atx/TWILight/README.md

TWILight
========

VGA-I2C Breakout board with few LEDs and Atmega. The footprint libraries used are the ones by [oshec](http://library.oshec.org/) and [Dangerous 
Prototypes](http://dangerousprototypes.com/2012/09/18/eagle-parts-our-eagle-library-converted-to-kicad/).
