atx/TWILight/pcb/i2c-vga.pdf

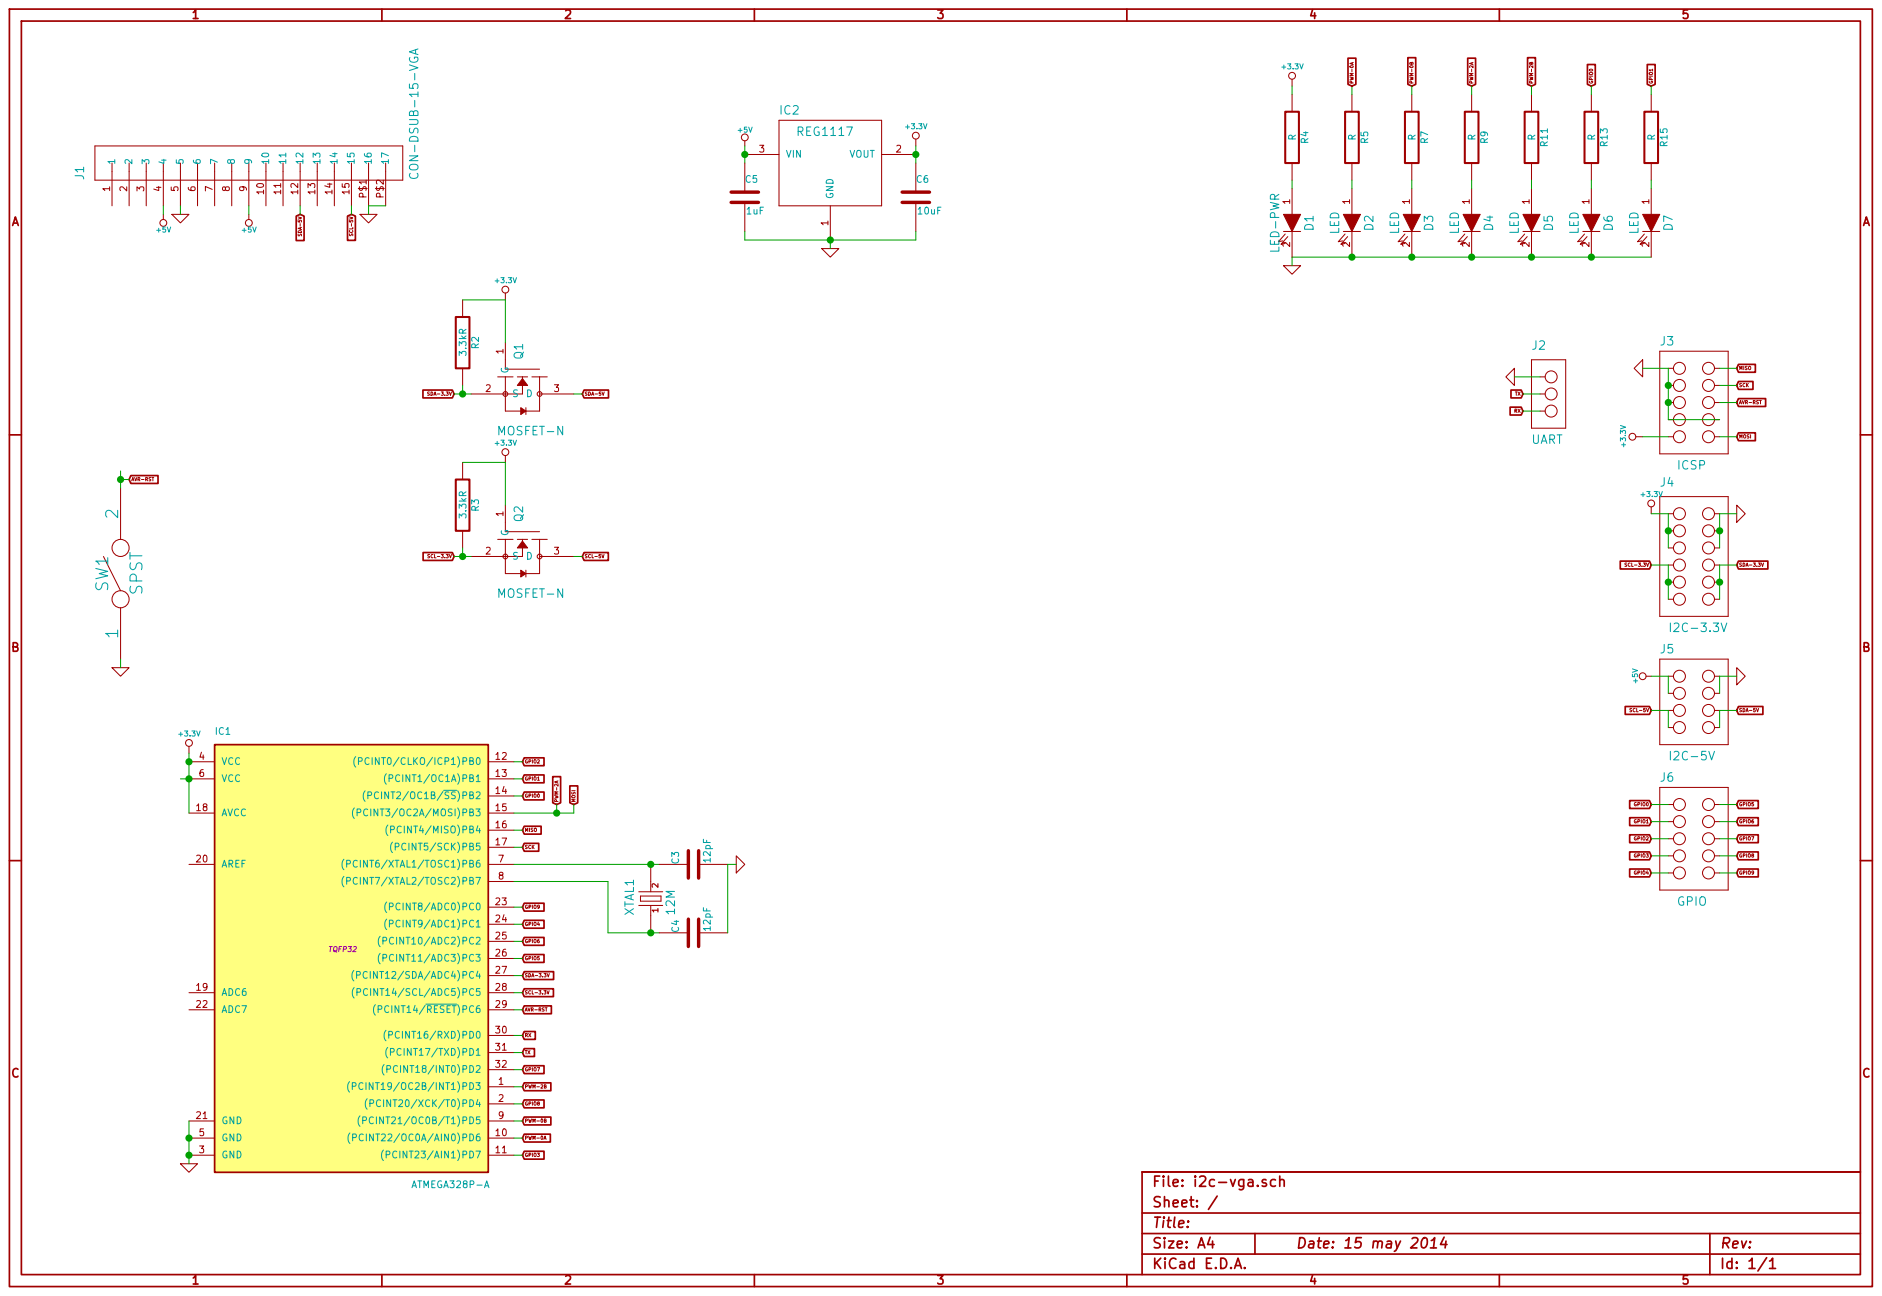
[picture p1: page 1]

MISO MOSI AVR-RST SCK J2UART

Id: 1/1 Title: File: i2c-vga.sch
