atx/TWILight/pcb/i2c-vga.kicad_pcb

## KiCad design pcb/i2c-vga.kicad_pcb (2014-05-15)

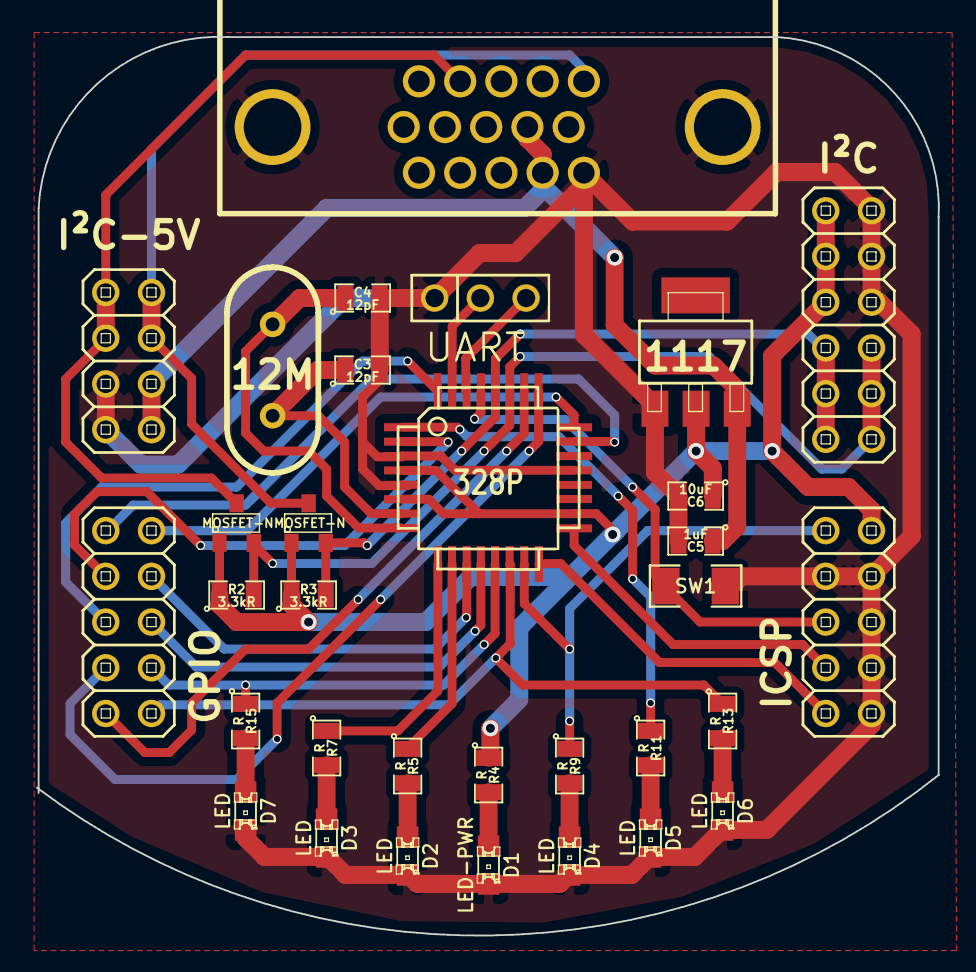
[picture p2: board i2c-vga.kicad_pcb from above]

Board: 2 copper layers, 50.1 x 49.9 mm, 21 parts (0 on the bottom side), 9 nets.

Parts:
C3, C4: 12pF; SM0805
C5: 1uF; SM0805
C6: 10uF; SM0805
D1: LED-PWR; LED-0805
D2, D3, D4, D5, D6, D7: LED; LED-0805
R2, R3: 3.3kR; SM0805
R4, R5, R7, R9, R11, R13, R15: R; SM0805
SW1: SPST; SM1206

Connections:
+3.3V: C6.1, R2.1, R3.1, R4.1
GND: C3.2, C4.2, C5.2, C6.2, D1.2, D2.2, D3.2, D4.2, D5.2, D6.2, D7.2, SW1.1
unnamed: D2.1, R5.2
unnamed: D7.1, R15.2
unnamed: D1.1, R4.2
unnamed: D3.1, R7.2
unnamed: D6.1, R13.2
unnamed: D5.1, R11.2
unnamed: D4.1, R9.2
