atx/TWILight/(commit log)

2014-05-15 Added KiCAD PCB sources.
    [i2c-vga.kicad_pcb, i2c-vga.sch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]
2014-05-18 Removed commented out printf in avr/main.c
2014-06-11 Added correct libraries to pcb/libs. KiCad project does no longer require the entire oshec library.
    [i2c-vga.sch]
2014-06-11 AVR FW now disables PWM when the compare register is set to zero. Even when the OCR register is zero, AVR in fast PWM mode produces short voltage bursts, so the LEDs were not dimmed properly.
    [main.c]
2014-06-11 Set F_CPU in Makefile to match the value on the schematic (12 MHz).
2014-06-14 Reworked the AVR I2C GPIO interface. Now we have atomic access to GPIO pins. Also this greatly simplifies driver code.
    [main.c]
2014-06-15 Added Linux kernel driver.
2014-06-16 Changed LED colors in source to match the ones on board.
2014-06-19 PWM now does not automatically start on reset.
    This means the LEDs are now properly turned off on power up.
    [main.c]
2014-06-22 Added rendered PDF file schematic
